veis-lzf/STM32_DSO_WAVE/readme.md

# STM32波形发生器和波形采集

- Ver_1.0.0.1版本
1. 支持解析AT调试指令
2. 支持HEX方式串口通讯协议数据解析
3. 通过串口进行采集波形数据/设置输出波形/修改波特率等
4. 基于HAL库实现ADC/DAC/USART的DMA应用
5. 待完善TFT LCD显示屏驱动和波形显示
