veis-lzf/STM32_DSO_WAVE/Hardware/BOM/BOM_Board1_STM32_Wave&DSO_2023-05-14.xlsx

No. | Quantity | Comment | Designator | Footprint | Value | Manufacturer Part | Manufacturer | Supplier Part | Supplier
1 | 10 | 100nF | C1,C2,C3,C4,C5,C6,C7,C9,C10,C25 | C0603 | 100nF | 0603B104K500NT | FH(风华) | C30926 | LCSC
2 | 8 | 10uF | C8,C16,C17,C19,C27,C30,C32,C33 | C0805 | 10uF | GRM21BR61H106KE43L | muRata(村田) | C440198 | LCSC
3 | 2 | 12pF | C11,C12 | C0603 | 12pF | 0603B104K500NT | FH(风华) |  | LCSC
4 | 2 | 10pF | C13,C14 | C0603 | 10pF | 0603B104K500NT | FH(风华) |  | LCSC
5 | 1 | 1uF/NC | C15 | C0603 | 1uF/NC
6 | 7 | 100nF | C18,C20,C21,C22,C24,C28,C31 | C0603 | 100nF | CC0603KRX7R9BB104 | YAGEO(国巨) | C14663 | LCSC
7 | 1 | 10nF/NC | C23 | C0603 | 10nF/NC | CC0603KRX7R9BB104 | YAGEO(国巨) |  | LCSC
8 | 1 | 100nF | C29 | C0603 | 100nF | CC0603KRX7R9BB104 | YAGEO(国巨) |  | LCSC
9 | 1 | X1251WRS-04HF-LPSW | CN1 | CONN-SMD_4P-P1.25_X1251WRS-04HF-LPSW |  | X1251WRS-04HF-LPSW | XKB Connectivity(中国星坤) | C388709 | LCSC | 已有
10 | 1 | SS24 | D1 | SMB_L4.6-W3.6-LS5.3-RD |  | SS24 | onsemi(安森美) | C232827 | LCSC | 已有
11 | 1 | SESR05 | D2 | SOT-143-4_L2.9-W1.3-P1.92-LS2.3-BL |  | SESR05 | SEMIWARE(赛米微尔) | C720027 | LCSC | 已有
12 | 1 | 4.7uH | L1 | L2520 | 4.7uH | TFM252012ALMA4R7MTAA | TDK | C404806 | LCSC | 已有
13 | 2 | CBW201209U601T | L2,L3 | L0805 |  | CBW201209U601T |  | C9900022857 | LCSC
14 | 2 |  | LED1,LED2 | LED_0603
15 | 1 | 0Ω | R1 | R0603 | 0Ω | 0603WAF0000T5E | UNI-ROYAL(厚声) | C21189 | LCSC
16 | 3 | 10K | R3,R10,R17 | R0603 | 10K | 0603WAF0000T5E | UNI-ROYAL(厚声) |  | LCSC
17 | 2 | 10 | R4,R5 | R0603 | 10
18 | 1 | 180K | R6 | R0603 | 180K |  |  |  |  | 已有
19 | 1 | 40.2K | R7 | R0603 | 40.2K |  |  |  |  | 已有
20 | 2 | 10K | R8,R12 | R0603 | 10K
21 | 2 | 0R | R9,R11 | R0603 | 0R
22 | 1 | 2K | R13 | R0603 | 2K
23 | 1 | 1K | R14 | R0603 | 1K
24 | 1 | 4.7K | R15 | R0603 | 4.7K
25 | 1 | 10K/NC | R16 | R0603 | 10K/NC | 0603WAF0000T5E | UNI-ROYAL(厚声) |  | LCSC
26 | 1 | K3-1391B-51 | SW2 | SW-TH_K3-1391B-51 |  | K3-1391B-51 | 韩国韩荣 | C92656 | LCSC | 已有
27 | 1 | STM32F407VET6 | U1 | LQFP-100_L14.0-W14.0-P0.50-LS16.0-BL |  | STM32F407VET6 | ST(意法半导体) | C28730 | LCSC | 待下单
28 | 1 | CH340C | U2 | SOP-16_L10.0-W3.9-P1.27-LS6.0-BL |  | CH340C | WCH(南京沁恒) | C84681 | LCSC | 待下单
29 | 1 | SY8089A1AAC | U3 | TSOT-23-5_L2.9-W1.6-P0.95-LS2.8-BR |  | SY8089A1AAC | silergy(矽力杰) | C479074 | LCSC | 已有
30 | 1 | XC6228D332VR-G | U4 | TSOT-23-5_L2.9-W1.6-P0.95-LS2.8-BR |  | XC6228D332VR-G | TOREX(特瑞仕) | C216642 | LCSC | 已有
31 | 1 |  | U5 | TFT-LCD 1.8 |  |  |  |  |  | 待下单
32 | 1 | OPA357AIDBVR | U7 | SOT-23-6_L2.9-W1.6-P0.95-LS2.8-BR |  | OPA357AIDBVR | TI(德州仪器) | C139385 | LCSC | 已有
33 | 2 | KF300-5.0-2P | U8,U9 | CONN-TH_P5.00_KF300-5.0-2P |  | KF300-5.0-2P | KEFA(科发) | C474885 | LCSC | 待下单
34 | 1 | TYPE-C-31-M-12 | USB1 | USB-C_SMD-TYPE-C-31-M-12 |  | TYPE-C-31-M-12 | 韩国韩荣 | C165948 | LCSC | 已有
35 | 1 | 8MHz | X1 | OSC-SMD_4P-L3.2-W2.5-BL | 8MHz | X32258MOB4SI | YXC(扬兴晶振) | C2682775 | LCSC | 已有
36 | 1 | 32.768kHz | X2 | MC-146_4P-L6.7-W1.5-P0.85-BL | 32.768kHz | M132768PWPAC | JYJE(晶友嘉) | C2847067 | LCSC | 已有
