veis-lzf/STM32_DSO_WAVE/Hardware/lceda_Project/DXF_STM32_Wave&DSO_V1.0_2023-05-14.dxf

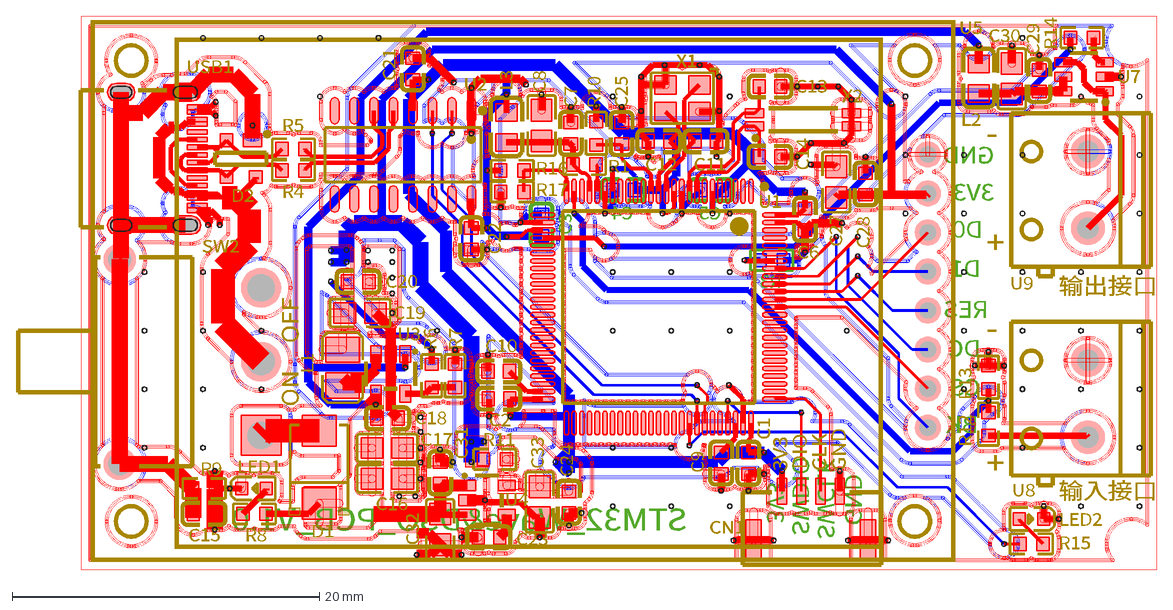
[picture p4: CAD file, 2023-07-16]
Hardware/lceda_Project/DXF_STM32_Wave&DSO_V1.0_2023-05-14.dxf
GND
3V3
D0
D1
RES
DC
CS
BK
SWDIO
SWCLK
C3
C4
C5
R3
STM32_Wave&DSO_PCB_V1.0
输出接口
输入接口
+
-
OFF
ON
CLK
DIO
U2
LED1
R8
R9
C15
USB1
R4
R5
D2
U3
C18
L1
R6
R7
C20
SW2
C21
C22
U4
C23
C24
R11
C31
C1
R1
C2
C6
C7
C9
C10
X1
C11
C12
X2
C13
C14
CN1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
