veis-lzf/STM32_DSO_WAVE/Hardware/lceda_Project/PCB_STM32_Wave&DSO_V1.0_2023-05-14.pdf

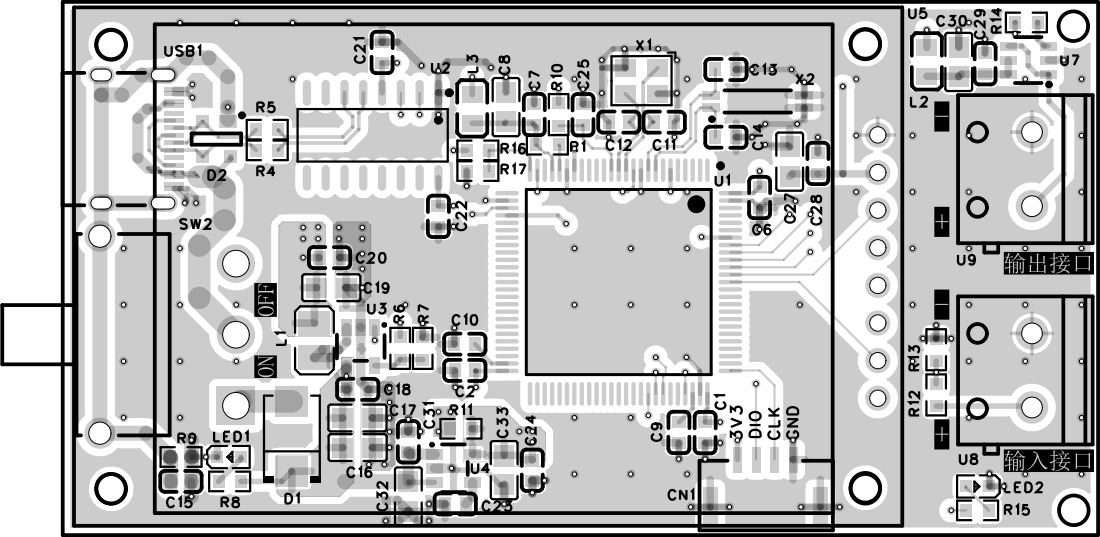
[picture p5: page 1]

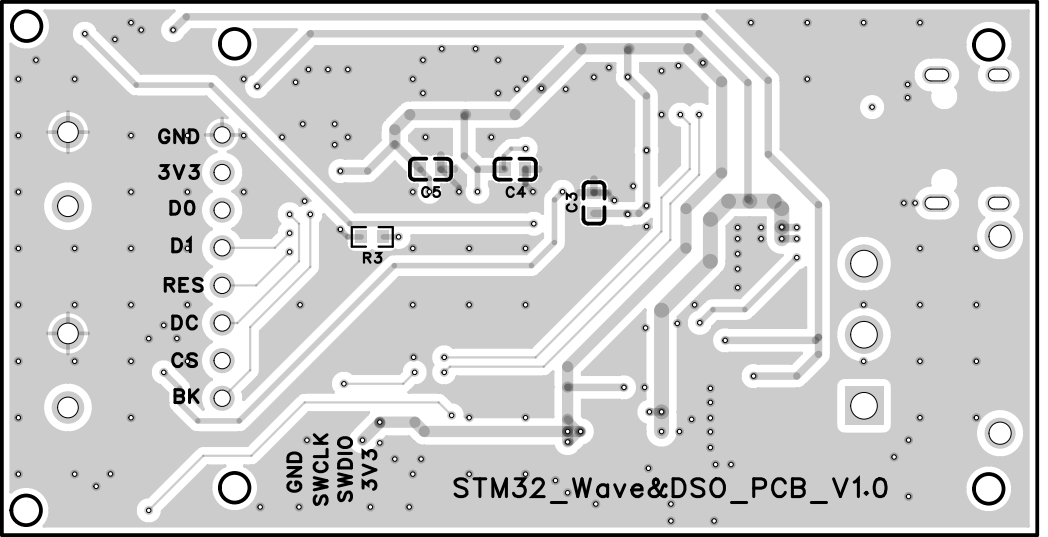
[picture p6: page 2]

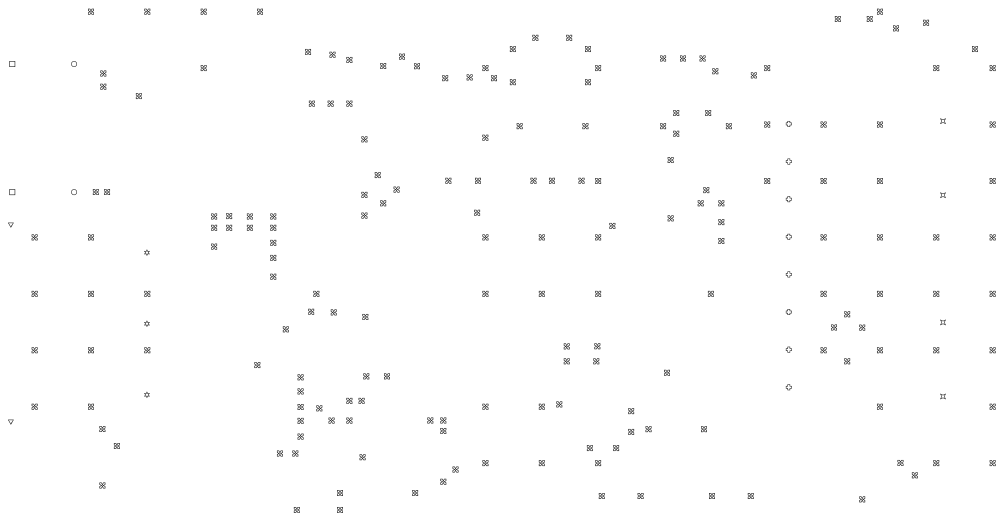
[picture p7: page 3]
