veis-lzf/STM32_DSO_WAVE/Hardware/lceda_Project/SCH_STM32_Wave&DSO_2023-05-14.pdf

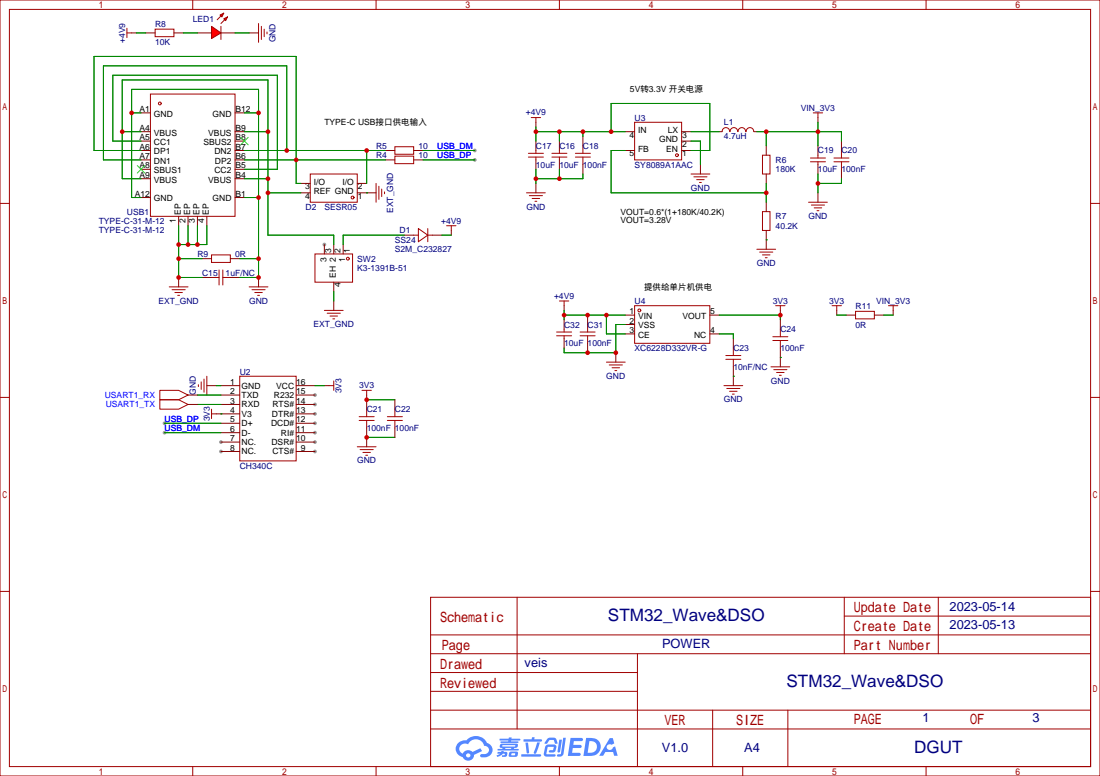
[picture p8: page 1]

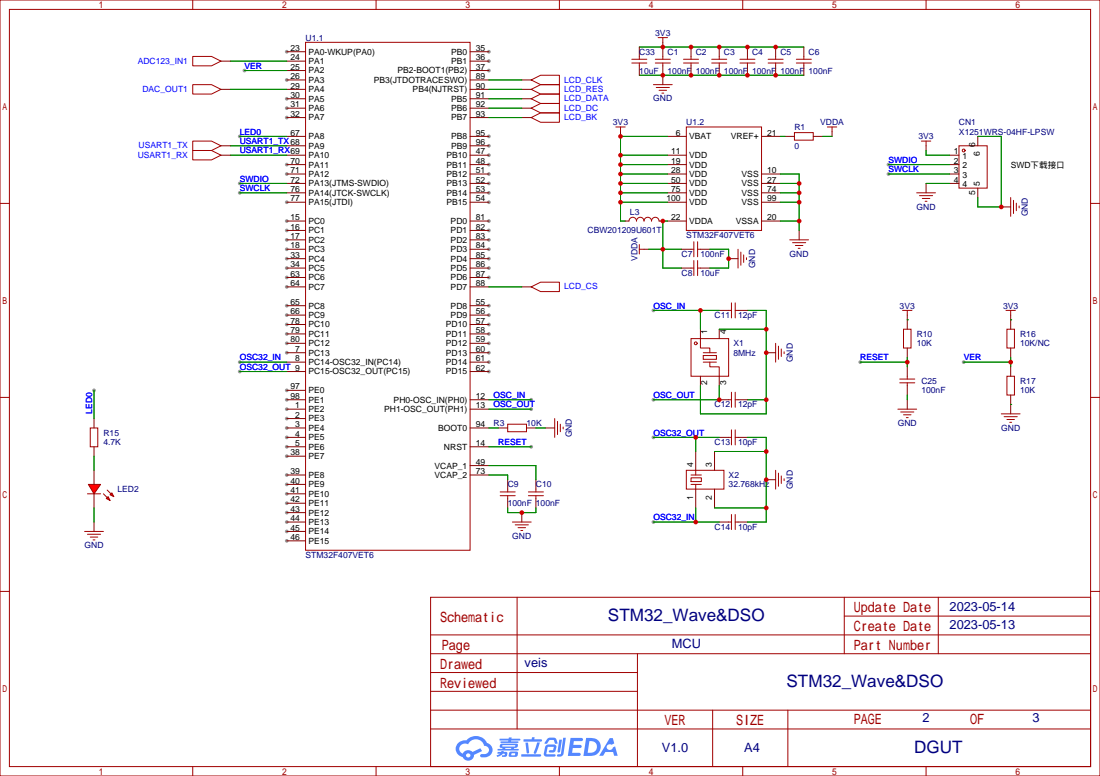
[picture p9: page 2]

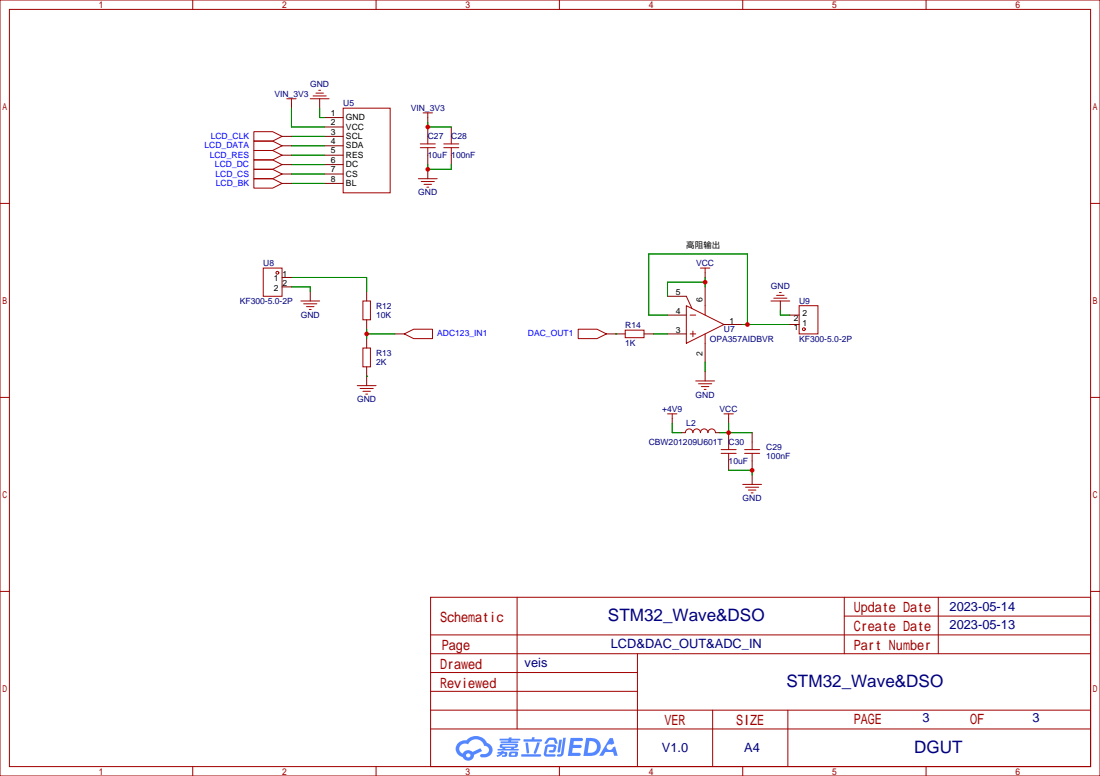
[picture p10: page 3]
