veis-lzf/STM32_DSO_WAVE/Software/bsp/Core/Inc/main.h

#define ADC123_IN1_Pin GPIO_PIN_1
#define ADC123_IN1_GPIO_Port GPIOA
#define VER_ADC_Pin GPIO_PIN_2
#define VER_ADC_GPIO_Port GPIOA
#define DAC_OUT1_Pin GPIO_PIN_4
#define DAC_OUT1_GPIO_Port GPIOA
#define LED0_Pin GPIO_PIN_8
#define LED0_GPIO_Port GPIOA
#define LCD_CS_Pin GPIO_PIN_7
#define LCD_CS_GPIO_Port GPIOD
#define LCD_CLK_Pin GPIO_PIN_3
#define LCD_CLK_GPIO_Port GPIOB
#define LCD_RES_Pin GPIO_PIN_4
#define LCD_RES_GPIO_Port GPIOB
#define LCD_DATA_Pin GPIO_PIN_5
#define LCD_DATA_GPIO_Port GPIOB
#define LCD_DC_Pin GPIO_PIN_6
#define LCD_DC_GPIO_Port GPIOB
#define LCD_BK_Pin GPIO_PIN_7
#define LCD_BK_GPIO_Port GPIOB
