veis-lzf/STM32_DSO_WAVE/Software/drivers/src/bsp_uart.c

#include "bsp_uart.h"
#include "protocol.h"

// 串口DMA接收缓冲区
uint8_t RX_BUFFER[RX_BUFFER_SIZE] = {0};
uint32_t rx_len = 0;

UART_HandleTypeDef huart1;
DMA_HandleTypeDef hdma_usart1_rx;
DMA_HandleTypeDef hdma_usart1_tx;

void bsp_uart1_init(uint32_t baund)
{
	 GPIO_InitTypeDef GPIO_InitStruct = {0};
	 
	__HAL_RCC_DMA2_CLK_ENABLE();
    __HAL_RCC_USART1_CLK_ENABLE();
    __HAL_RCC_GPIOA_CLK_ENABLE();
    /**USART1 GPIO Configuration
    PA9     ------> USART1_TX
    PA10     ------> USART1_RX
    */
    GPIO_InitStruct.Pin = GPIO_PIN_9|GPIO_PIN_10;
    GPIO_InitStruct.Mode = GPIO_MODE_AF_PP;
    GPIO_InitStruct.Pull = GPIO_NOPULL;
    GPIO_InitStruct.Speed = GPIO_SPEED_FREQ_VERY_HIGH;
    GPIO_InitStruct.Alternate = GPIO_AF7_USART1;
    HAL_GPIO_Init(GPIOA, &GPIO_InitStruct);

	huart1.Instance = USART1;
	huart1.Init.BaudRate = baund;
	huart1.Init.WordLength = UART_WORDLENGTH_8B;
	huart1.Init.StopBits = UART_STOPBITS_1;
	huart1.Init.Parity = UART_PARITY_NONE;
	huart1.Init.Mode = UART_MODE_TX_RX;
	huart1.Init.HwFlowCtl = UART_HWCONTROL_NONE;
	huart1.Init.OverSampling = UART_OVERSAMPLING_16;
	if (HAL_UART_Init(&huart1) != HAL_OK)
	{
		Error_Handler();
	}

    hdma_usart1_rx.Instance = DMA2_Stream2;
    hdma_usart1_rx.Init.Channel = DMA_CHANNEL_4;
    hdma_usart1_rx.Init.Direction = DMA_PERIPH_TO_MEMORY;
    hdma_usart1_rx.Init.PeriphInc = DMA_PINC_DISABLE;
    hdma_usart1_rx.Init.MemInc = DMA_MINC_ENABLE;
    hdma_usart1_rx.Init.PeriphDataAlignment = DMA_PDATAALIGN_BYTE;
    hdma_usart1_rx.Init.MemDataAlignment = DMA_MDATAALIGN_BYTE;
    hdma_usart1_rx.Init.Mode = DMA_NORMAL;
    hdma_usart1_rx.Init.Priority = DMA_PRIORITY_MEDIUM;
    hdma_usart1_rx.Init.FIFOMode = DMA_FIFOMODE_DISABLE;
    if (HAL_DMA_Init(&hdma_usart1_rx) != HAL_OK)
    {
		Error_Handler();
    }

    __HAL_LINKDMA(&huart1,hdmarx,hdma_usart1_rx);
	    /* USART1_TX Init */
    hdma_usart1_tx.Instance = DMA2_Stream7;
    hdma_usart1_tx.Init.Channel = DMA_CHANNEL_4;
    hdma_usart1_tx.Init.Direction = DMA_MEMORY_TO_PERIPH;
    hdma_usart1_tx.Init.PeriphInc = DMA_PINC_DISABLE;
    hdma_usart1_tx.Init.MemInc = DMA_MINC_ENABLE;
    hdma_usart1_tx.Init.PeriphDataAlignment = DMA_PDATAALIGN_BYTE;
    hdma_usart1_tx.Init.MemDataAlignment = DMA_MDATAALIGN_BYTE;
    hdma_usart1_tx.Init.Mode = DMA_NORMAL;
    hdma_usart1_tx.Init.Priority = DMA_PRIORITY_MEDIUM;
    hdma_usart1_tx.Init.FIFOMode = DMA_FIFOMODE_DISABLE;
    if (HAL_DMA_Init(&hdma_usart1_tx) != HAL_OK)
    {
      Error_Handler();
    }

    __HAL_LINKDMA(&huart1,hdmatx,hdma_usart1_tx);
	
    HAL_NVIC_SetPriority(USART1_IRQn, 1, 1);
    HAL_NVIC_EnableIRQ(USART1_IRQn);
	// 启动DMA接收
	HAL_UART_Receive_DMA(&huart1, RX_BUFFER, RX_BUFFER_SIZE);
	// 使能空闲帧中断
	__HAL_UART_ENABLE_IT(&huart1, UART_IT_IDLE);
}


void HAL_UART_RxCpltCallback(UART_HandleTypeDef *huart)
{
	if(huart->Instance == USART1)
	{
		HAL_UART_DMAStop(huart);
		rx_len = RX_BUFFER_SIZE - __HAL_DMA_GET_COUNTER(huart->hdmarx);
		Receive_Handle();
		memset(RX_BUFFER, 0, RX_BUFFER_SIZE);
		HAL_UART_Receive_DMA(huart, RX_BUFFER, RX_BUFFER_SIZE);
	}
}
